Jarredli/CaneVision_Smart_White_Cane_for_the_Visually_Impaired/(notices)

Notices in the files:
README.md:
License: MIT
